opensprints/opensprints-hw/a-31_modifications/panel-sensors_text.dxf

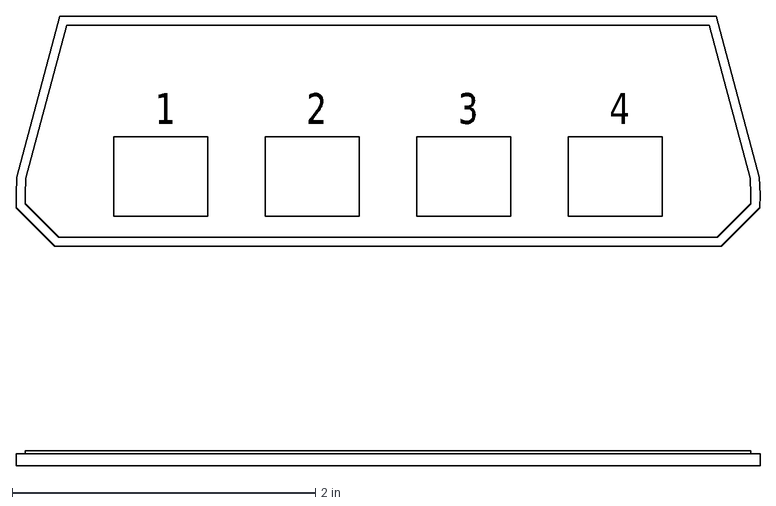
[picture p1: CAD file, 2014-02-09]
a-31_modifications/panel-sensors_text.dxf
1
2
3
4
