opensprints/opensprints-hw/c-6_modifications/c-6_RJ45_cutouts.dxf

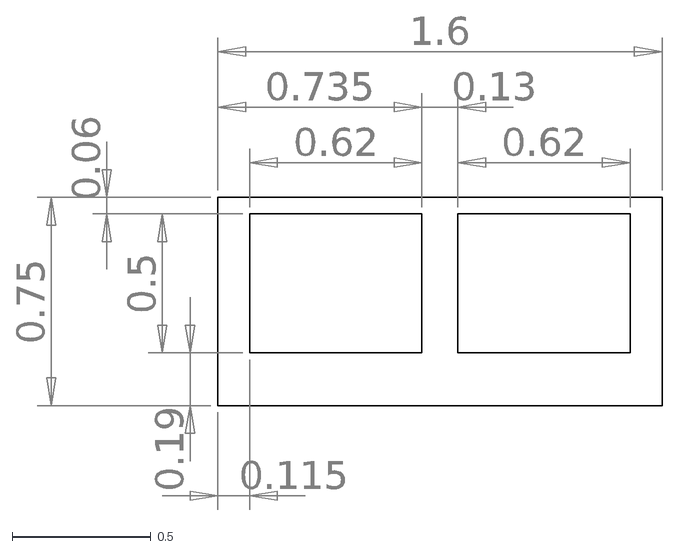
[picture p2: CAD file, 2014-02-09]
c-6_modifications/c-6_RJ45_cutouts.dxf
0.75
0.06
0.5
0.19
1.6
0.735
0.13
0.62
0.115
