opensprints/opensprints-hw/a-31_modifications/panel-arduino_text.dxf

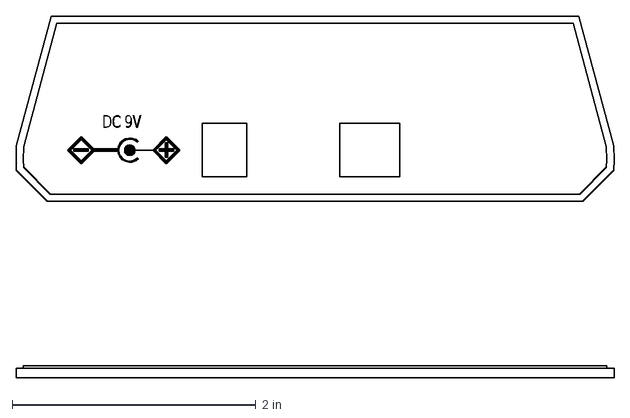
[picture p3: CAD file, 2014-02-09]
a-31_modifications/panel-arduino_text.dxf
DC\~9V
