opensprints/opensprints-hw/a-31_modifications/a-31.dxf

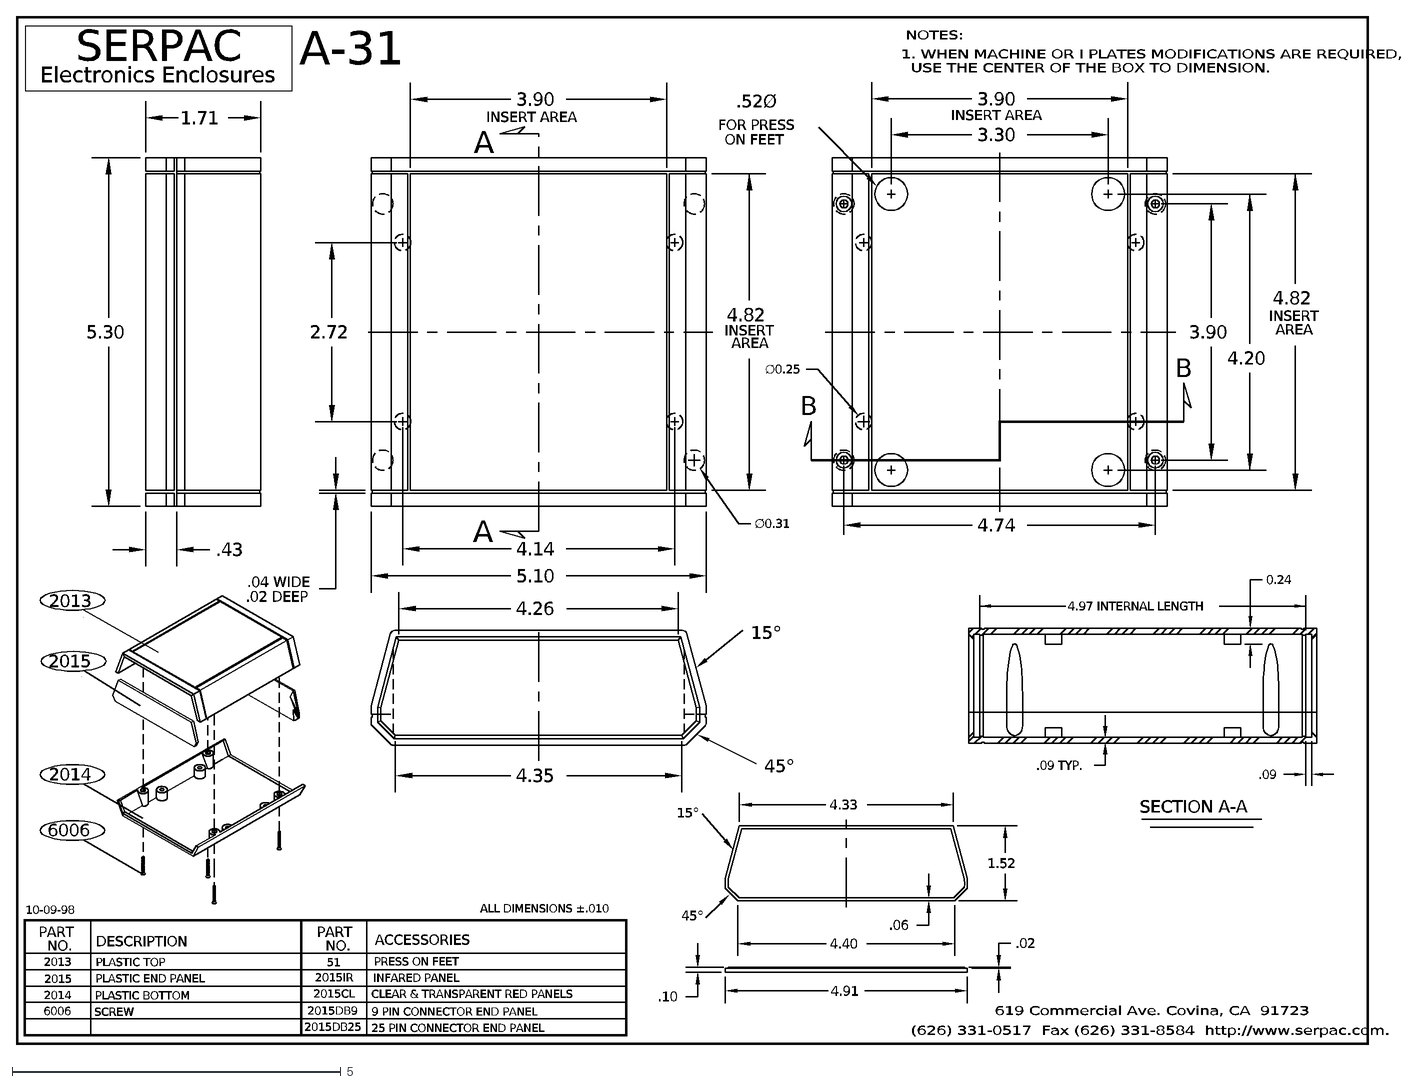
[picture p4: CAD file, 2014-02-09]
a-31_modifications/a-31.dxf
1.52
(626) 331-0517 Fax (626) 331-8584 http://www.serpac.com.
PLASTIC BOTTOM
PLASTIC TOP
DESCRIPTION
PLASTIC END PANEL
2014
6006
2013
2015
NO.
SCREW
10-09-98
PART
ALL DIMENSIONS ±.010
CLEAR & TRANSPARENT RED PANELS
2015CL
2015IR
51
ACCESSORIES
PRESS ON FEET
INFARED PANEL
4.35
45°
.10
15°
4.91
4.40
4.33
.06
619 Commercial Ave. Covina, CA 91723
SECTION A-A
.02
.09 TYP.
.09
3.90
3.30
INSERT AREA
USE THE CENTER OF THE BOX TO DIMENSION.
4.74
1. WHEN MACHINE OR I PLATES MODIFICATIONS ARE REQUIRED,
SERPAC
Electronics Enclosures
5.30
2.72
.43
.02 DEEP
.04 WIDE
4.26
A
5.10
4.14
A-31
1.71
INSERT
4.82
AREA
B
ON FEET
FOR PRESS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
