opensprints/opensprints-hw/interface_board/kicad/interface_board.sch

## KiCad design interface_board/kicad/interface_board.sch (2014-02-09)

Schematic: interface_board.sch

Parts:
D1: LED
J1, J2, J3, J4: RJ45
P1, P2, P3, P4: CONN_8
R1: 100
U1: ARDUINO_USB
U2: A-31-CB

Notes on the sheet:
circuit board
dimensions
