opensprints/opensprints-hw/interface_board/kicad/interface_board_sh2.sch

## KiCad design interface_board/kicad/interface_board_sh2.sch (2014-02-09)

Schematic: interface_board_sh2.sch

Parts:
K1: CONN_3
P15, P16, P17, P18: CONN_8
P19, P20, P21, P22, P35, P36, P38: CONN_6
P23, P24, P25: PROTO_7X8
P26, P27: PROTO_12X1
P28, P33: PROTO_12X8
P29: PROTO_15X25
P30: PROTO_12X25
P31, P32: CONN_12
P34: CONN_4
P39: CONN_5
P40: PROTO_6X5
P41: PROTO_2X7
P42: PROTO_2X5

Notes on the sheet:
lower right
lower left
upper right
upper left
upper center
PROTOTYPING AREA
