opensprints/opensprints-hw/roller_sensor/kicad/roller_sensor.sch

## KiCad design roller_sensor/kicad/roller_sensor.sch (2014-02-09)

Schematic: roller_sensor.sch

Parts:
C1: C
CB1: C-6_CIRCUIT_BOARD
D1: RED LED
D2: GRN LED
D3: WHT LED
J1, J2: RJ45
P1: CONN_8
P2: PROTOTYPING_PINS
P3, P4, P5, P6: JUMPER_PIN
R1: 150
R2, R3: 68
U1, U2, U3, U4: SS441A

Notes on the sheet:
P5 and P4 to P6.
Then connect P3 to
is broken.
between P4 and P6
and the connection
P3 and P5 is broken
connection between
backwards if the
may be installed
The hall sensors
and don't place D2 and R2.
GND instead of this pad
connect this lead to
To use D1 as power indicator,
hall effect sensor.
Install only one
