opensprints/opensprints-hw/(commit log)

2014-02-09 Initial, recursively copied hardware/ from:
    https://github.com/evanfarrar/opensprints
    commit 6298796e3fe7ccb1a1fb119a89abc2db8250633d
    [a-31.dxf, c-6_RJ45_cutouts.dxf, faceplate_sticker.brd, interface_board.brd, interface_board.sch, interface_board_sh2.sch, panel-arduino_text.dxf, panel-sensors_text.dxf]
2014-02-17 Increas diameter of hole for center post
    to 0.3126 inches.
    [roller_sensor.brd]
2014-02-17 Add Soldermask gerbers to the non-barebones archive targets
2014-02-17 Move text
    [roller_sensor.brd]
2014-06-09 Shorten length of roller sensor PCB
    by 0.05 inches (1.27 mm) from each end for a total of 0.1 inches shorter.
    Update dimension markings
    Update roller sensor version
    [roller_sensor.brd]
